kaini/eink-clock/graphics/large_0.png

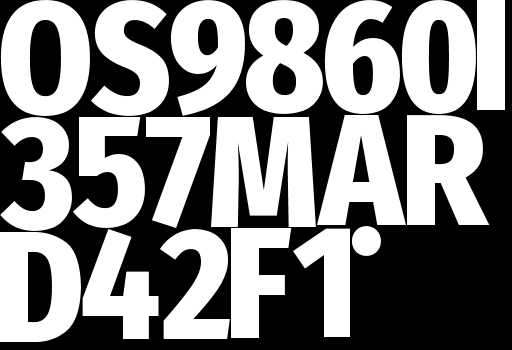
graphics/large_0.png
