kaini/eink-clock/graphics/small_0.png

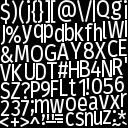
graphics/small_0.png
