kaini/eink-clock/parts.txt

Special Parts

Crystal: 
L1, L4: SDR0703-120KL
L2, L3, L5, L6: CBC3225T100KRV
RV1: TS53YL103MR10
Y1: AB26TRQ-32.768kHz-T
