kaini/eink-clock/kicad/einkclock.kicad_pcb

## KiCad design kicad/einkclock.kicad_pcb (2021-10-04)

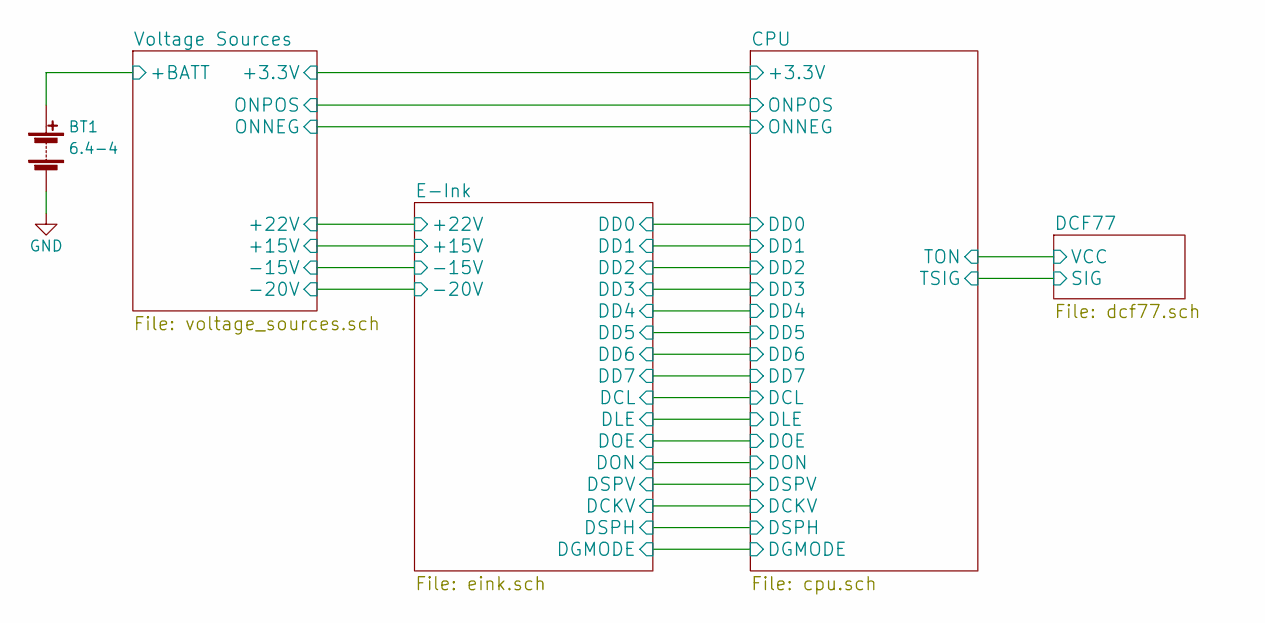
[picture p3: schematic einkclock.sch, E-Ink Clock]

Parts:
BT1: 6.4-4; WireConnection_1.00mmDrill

Connections:
GND: BT1.2 (-); also elsewhere on the board

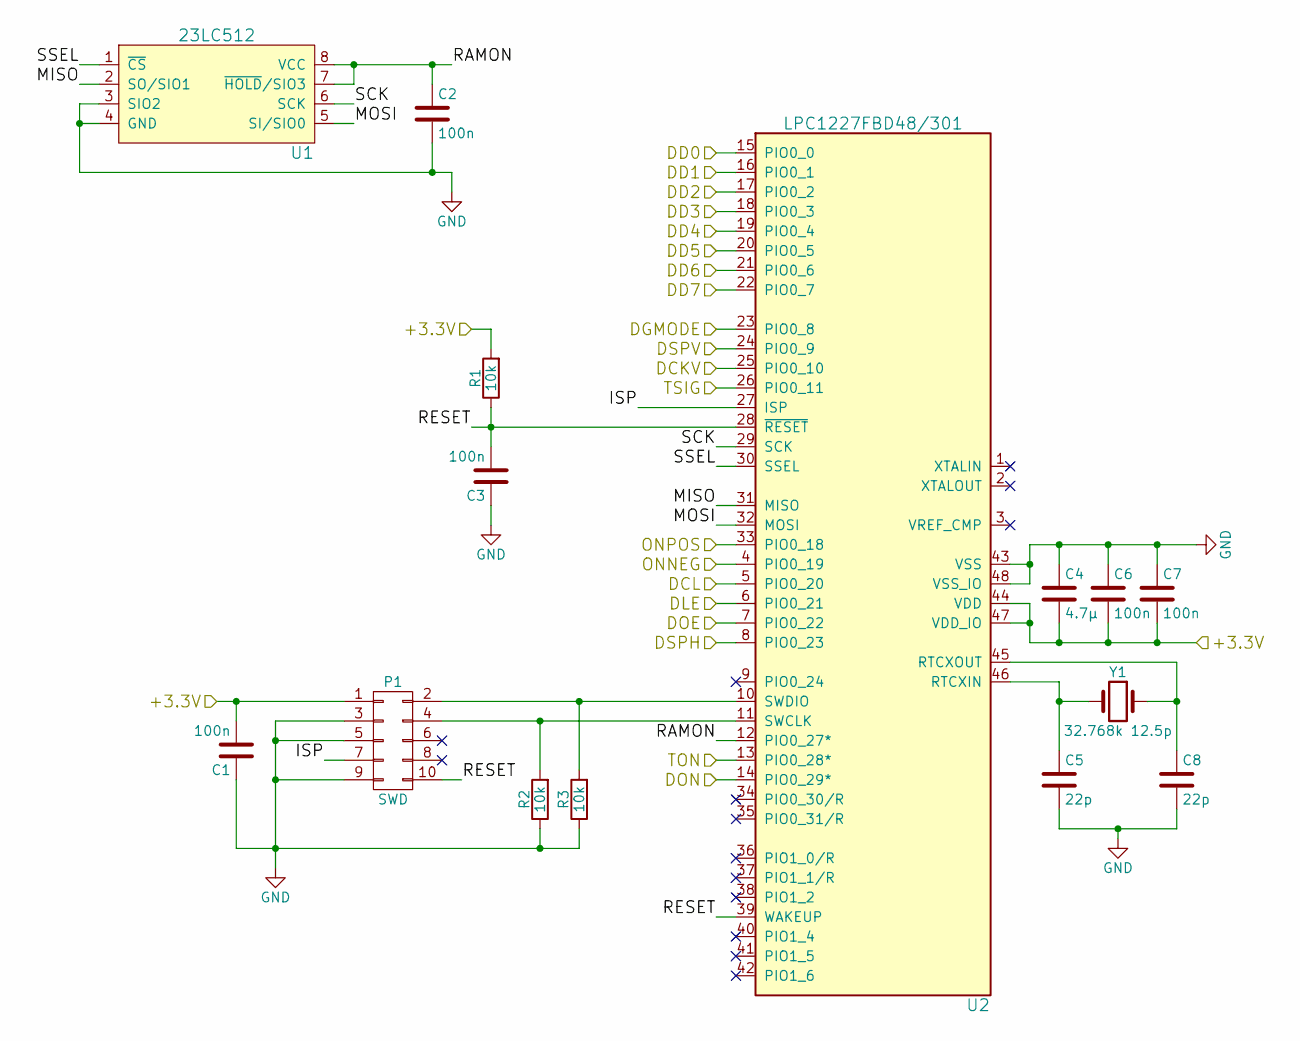
[picture p4: schematic cpu.sch, E-Ink Clock]

Parts:
C1, C2, C3, C6, C7: 100n; R_0805_HandSoldering
C4: 4.7µ; R_0805_HandSoldering
C5, C8: 22p; R_0805_HandSoldering
P1: SWD; IDC_Header_Straight_10pins
R1, R2, R3: 10k; R_0805_HandSoldering
U1: 23LC512; SOIC-8_3.9x4.9mm_Pitch1.27mm
U2: LPC1227FBD48/301; LQFP-48_7x7mm_Pitch0.5mm
Y1: 32.768k 12.5p; Crystal_Lying_1

Connections:
/CPU/+3.3V: C1.2, C4.2, C6.2, C7.2, P1.1, R1.2, U2.44 (VDD), U2.47 (VDD_IO); also elsewhere on the board
/CPU/DCKV: U2.25 (PIO0_10); also elsewhere on the board
/CPU/DCL: U2.5 (PIO0_20); also elsewhere on the board
/CPU/DD0: U2.15 (PIO0_0); also elsewhere on the board
/CPU/DD1: U2.16 (PIO0_1); also elsewhere on the board
/CPU/DD2: U2.17 (PIO0_2); also elsewhere on the board
/CPU/DD3: U2.18 (PIO0_3); also elsewhere on the board
/CPU/DD4: U2.19 (PIO0_4); also elsewhere on the board
/CPU/DD5: U2.20 (PIO0_5); also elsewhere on the board
/CPU/DD6: U2.21 (PIO0_6); also elsewhere on the board
/CPU/DD7: U2.22 (PIO0_7); also elsewhere on the board
/CPU/DGMODE: U2.23 (PIO0_8); also elsewhere on the board
/CPU/DLE: U2.6 (PIO0_21); also elsewhere on the board
/CPU/DOE: U2.7 (PIO0_22); also elsewhere on the board
/CPU/DON: U2.14 (PIO0_29*); also elsewhere on the board
/CPU/DSPH: U2.8 (PIO0_23); also elsewhere on the board
/CPU/DSPV: U2.24 (PIO0_9); also elsewhere on the board
/CPU/ISP: P1.7, U2.27 (ISP)
/CPU/MISO: U1.2 (SO/SIO1), U2.31 (MISO)
/CPU/MOSI: U1.5 (SI/SIO0), U2.32 (MOSI)
/CPU/ONPOS: U2.33 (PIO0_18); also elsewhere on the board
/CPU/RAMON: C2.1, U1.7 (~HOLD~/SIO3), U1.8 (VCC), U2.12 (PIO0_27*)
/CPU/RESET: C3.2, P1.10, R1.1, U2.28 (~RESET), U2.39 (WAKEUP)
/CPU/SCK: U1.6 (SCK), U2.29 (SCK)
/CPU/SSEL: U1.1 (~CS), U2.30 (SSEL)
/CPU/TON: U2.13 (PIO0_28*); also elsewhere on the board
/DCF77/SIG: U2.26 (PIO0_11); also elsewhere on the board
GND: C1.1, C2.2, C3.1, C4.1, C5.2, C6.1, C7.1, C8.2, P1.3, P1.5, P1.9, R2.1, R3.1, U1.3 (SIO2), U1.4 (GND), U2.43 (VSS), U2.48 (VSS_IO); also elsewhere on the board
unnamed: C5.1, U2.46 (RTCXIN), Y1.2
unnamed: C8.1, U2.45 (RTCXOUT), Y1.1
unnamed: P1.2, R3.2, U2.10 (SWDIO)
unnamed: P1.4, R2.2, U2.11 (SWCLK)

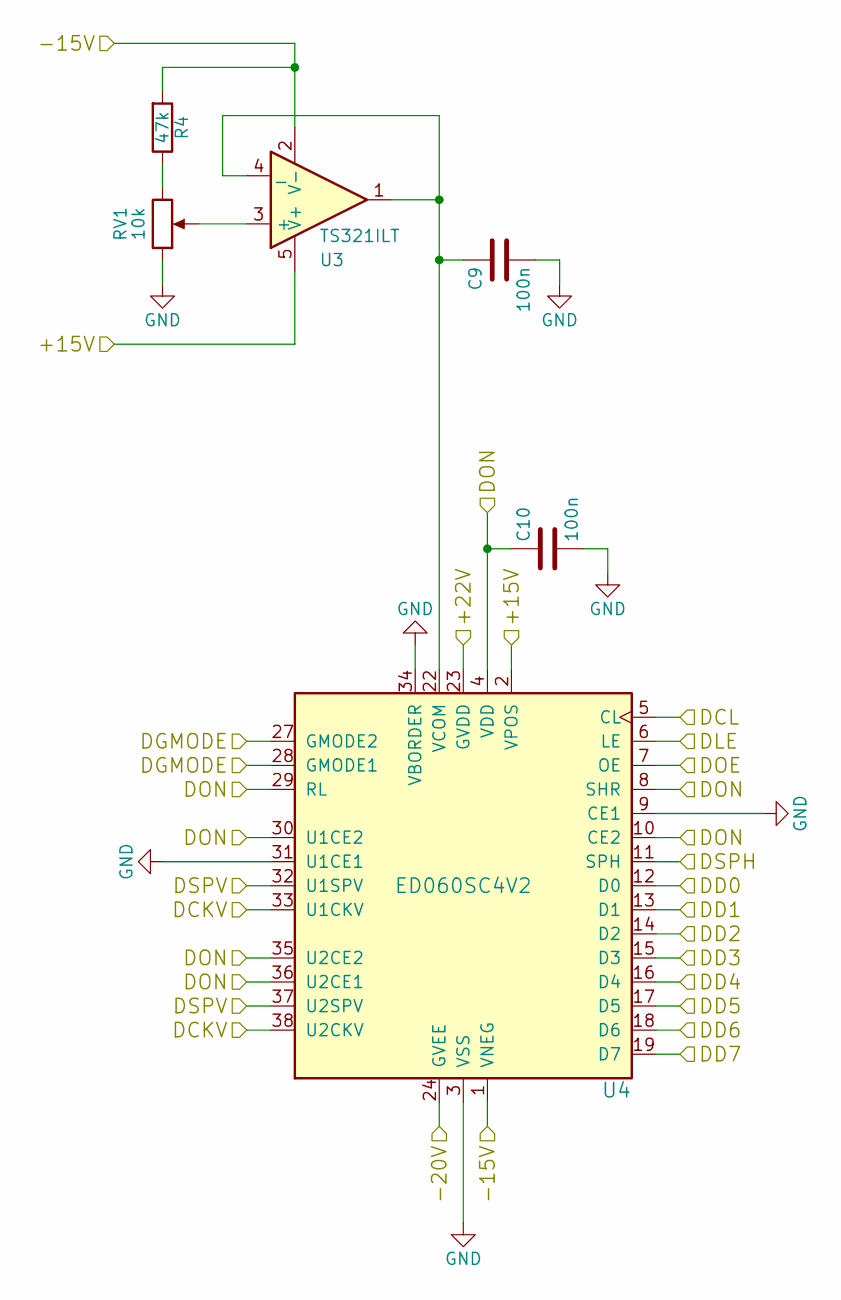
[picture p5: schematic eink.sch, E-Ink Clock]

Parts:
C9, C10: 100n; R_0805_HandSoldering
R4: 47k; R_0805_HandSoldering
RV1: 10k; Potentiometer_Trimmer_Vishay_TS53YL
U3: TS321ILT; SOT-23-5_HandSoldering
U4: ED060SC4V2; Hirose_FH26-39S-0.3SHW

Connections:
/CPU/DCKV: U4.33 (U1CKV), U4.38 (U2CKV); also elsewhere on the board
/CPU/DCL: U4.5 (CL); also elsewhere on the board
/CPU/DD0: U4.12 (D0); also elsewhere on the board
/CPU/DD1: U4.13 (D1); also elsewhere on the board
/CPU/DD2: U4.14 (D2); also elsewhere on the board
/CPU/DD3: U4.15 (D3); also elsewhere on the board
/CPU/DD4: U4.16 (D4); also elsewhere on the board
/CPU/DD5: U4.17 (D5); also elsewhere on the board
/CPU/DD6: U4.18 (D6); also elsewhere on the board
/CPU/DD7: U4.19 (D7); also elsewhere on the board
/CPU/DGMODE: U4.27 (GMODE2), U4.28 (GMODE1); also elsewhere on the board
/CPU/DLE: U4.6 (LE); also elsewhere on the board
/CPU/DOE: U4.7 (OE); also elsewhere on the board
/CPU/DON: C10.1, U4.4 (VDD), U4.8 (SHR), U4.10 (CE2), U4.29 (RL), U4.30 (U1CE2), U4.35 (U2CE2), U4.36 (U2CE1); also elsewhere on the board
/CPU/DSPH: U4.11 (SPH); also elsewhere on the board
/CPU/DSPV: U4.32 (U1SPV), U4.37 (U2SPV); also elsewhere on the board
/E-Ink/+15V: U3.5 (V+), U4.2 (VPOS); also elsewhere on the board
/E-Ink/+22V: U4.23 (GVDD); also elsewhere on the board
/E-Ink/-15V: R4.2, U3.2 (V-), U4.1 (VNEG); also elsewhere on the board
/E-Ink/-20V: U4.24 (GVEE); also elsewhere on the board
GND: C9.2, C10.2, RV1.1, U4.3 (VSS), U4.9 (CE1), U4.31 (U1CE1), U4.34 (VBORDER); also elsewhere on the board
unnamed: C9.1, U3.1, U3.4 (_), U4.22 (VCOM)
unnamed: R4.1, RV1.3
unnamed: RV1.2, U3.3 (+)

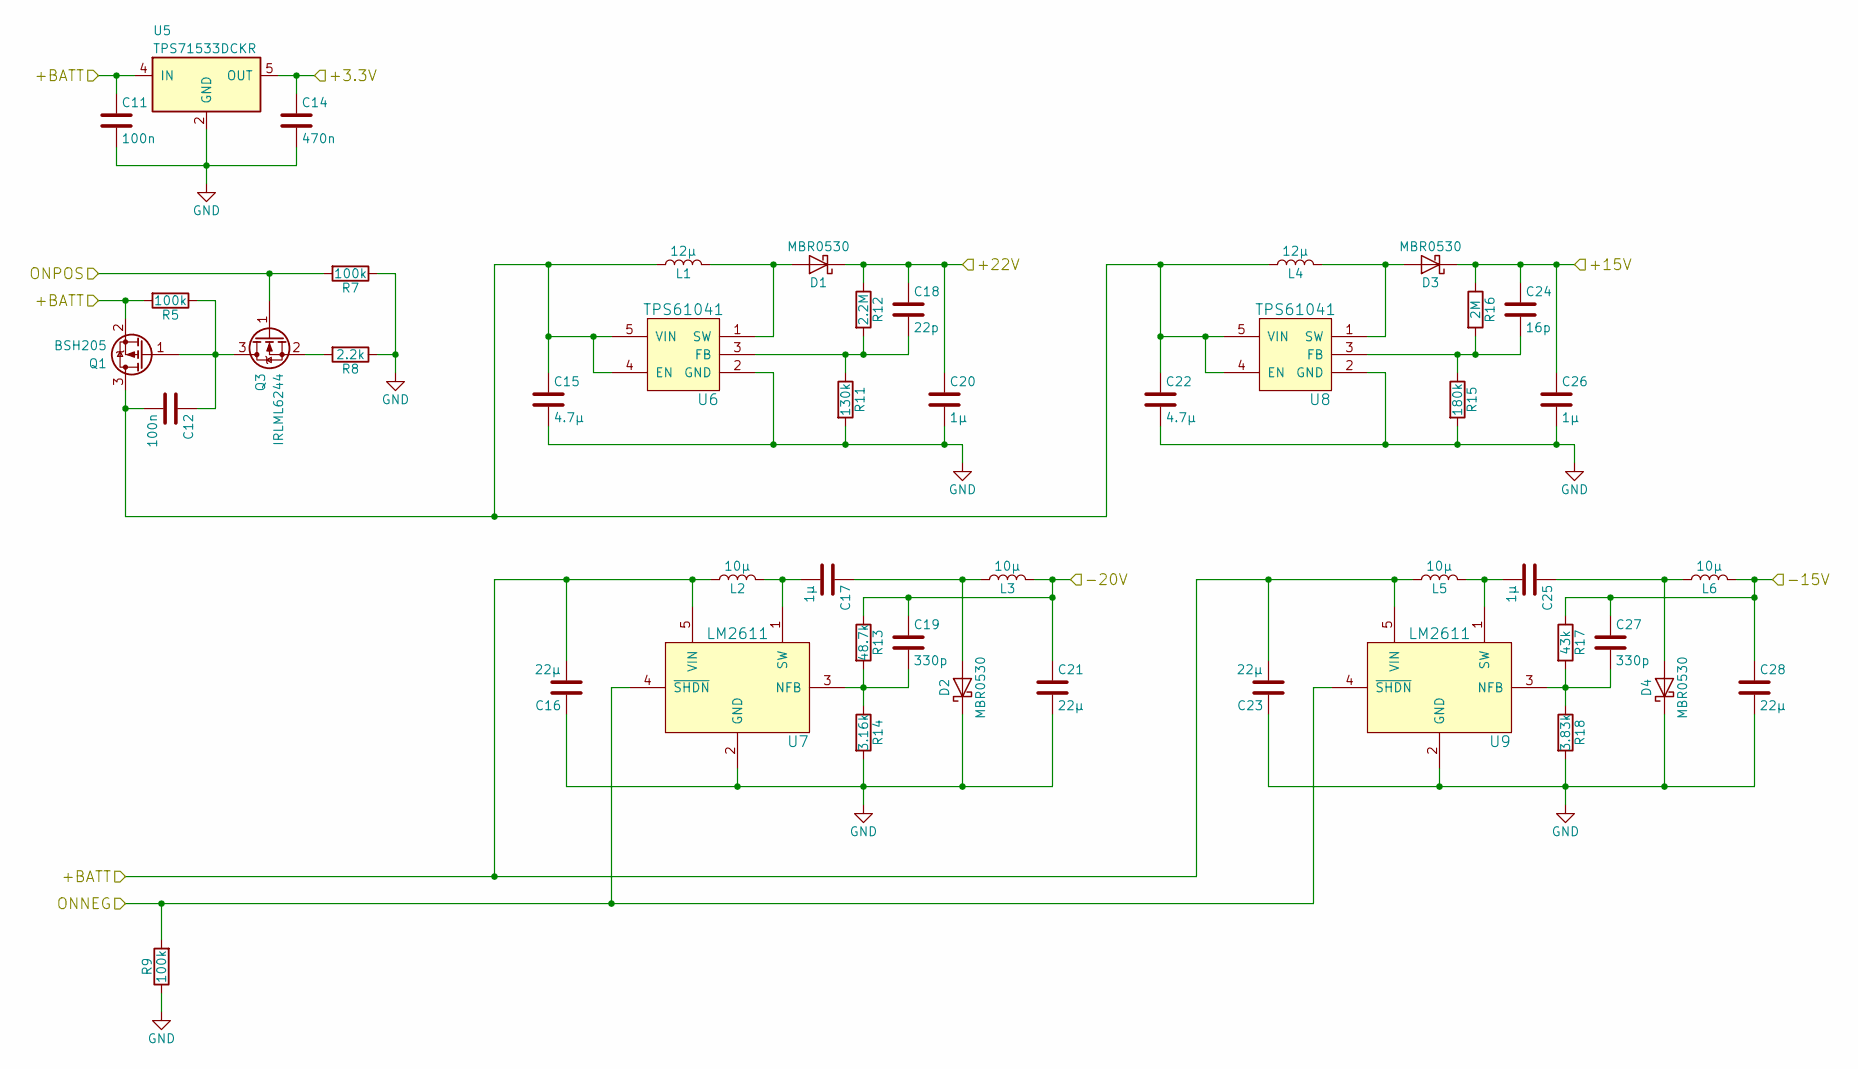
[picture p6: schematic voltage_sources.sch, E-Ink Clock]

Parts:
C11, C12: 100n; R_0805_HandSoldering
C14: 470n; R_0805_HandSoldering
C15, C22: 4.7µ; R_0805_HandSoldering
C16, C21, C23, C28: 22µ; R_0805_HandSoldering
C17, C20, C25, C26: 1µ; R_0805_HandSoldering
C18: 22p; R_0805_HandSoldering
C19, C27: 330p; R_0805_HandSoldering
C24: 16p; R_0805_HandSoldering
D1, D2, D3, D4: MBR0530; D_SOD-123
L1, L4: 12µ; Bourns_Inductor_SDR0703
L2, L3, L5, L6: 10µ; Inductor_TAIYO_YUDEN_3225
Q1: BSH205; SOT-23_Handsoldering
Q3: IRLML6244; SOT-23_Handsoldering
R5, R7, R9: 100k; R_0805_HandSoldering
R8: 2.2k; R_0805_HandSoldering
R11: 130k; R_0805_HandSoldering
R12: 2.2M; R_0805_HandSoldering
R13: 48.7k; R_0805_HandSoldering
R14: 3.16k; R_0805_HandSoldering
R15: 180k; R_0805_HandSoldering
R16: 2M; R_0805_HandSoldering
R17: 43k; R_0805_HandSoldering
R18: 3.83k; R_0805_HandSoldering
U5: TPS71533DCKR; SOT-353_SC-70-5_Handsoldering
U6, U8: TPS61041; SOT-23-5_HandSoldering
U7, U9: LM2611; SOT-23-5_HandSoldering

Connections:
/CPU/+3.3V: C14.1, U5.5 (OUT); also elsewhere on the board
/CPU/ONPOS: Q3.1 (G), R7.2; also elsewhere on the board
/E-Ink/+15V: C24.1, C26.1, D3.1 (K), R16.1; also elsewhere on the board
/E-Ink/+22V: C18.1, C20.1, D1.1 (K), R12.1; also elsewhere on the board
/E-Ink/-15V: C27.1, C28.1, L6.2, R17.1; also elsewhere on the board
/E-Ink/-20V: C19.1, C21.1, L3.2, R13.1; also elsewhere on the board
GND: C11.2, C14.2, C15.2, C16.1, C20.2, C21.2, C22.2, C23.1, C26.2, C28.2, D2.1 (K), D4.1 (K), R7.1, R8.1, R9.1, R11.2, R14.2, R15.2, R18.2, U5.2 (GND), U6.2 (GND), U7.2 (GND), U8.2 (GND), U9.2 (GND); also elsewhere on the board
unnamed: C12.1, Q1.1 (G), Q3.3 (D), R5.1
unnamed: C12.2, C15.1, C22.1, L1.1, L4.1, Q1.3 (D), U6.4 (EN), U6.5 (VIN), U8.4 (EN), U8.5 (VIN)
unnamed: C17.1, D2.2 (A), L3.1
unnamed: C17.2, L2.2, U7.1 (SW)
unnamed: C18.2, R11.1, R12.2, U6.3 (FB)
unnamed: C19.2, R13.2, R14.1, U7.3 (NFB)
unnamed: C24.2, R15.1, R16.2, U8.3 (FB)
unnamed: C25.1, D4.2 (A), L6.1
unnamed: C25.2, L5.2, U9.1 (SW)
unnamed: C27.2, R17.2, R18.1, U9.3 (NFB)
unnamed: D1.2 (A), L1.2, U6.1 (SW)
unnamed: D3.2 (A), L4.2, U8.1 (SW)
unnamed: Q3.2 (S), R8.2

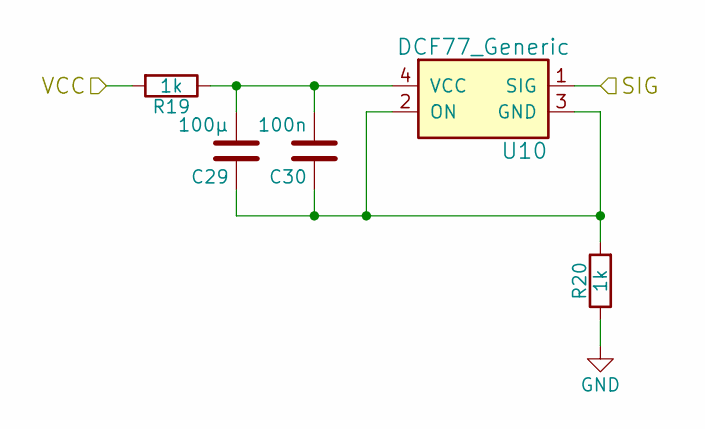
[picture p7: schematic dcf77.sch, E-Ink Clock]

Parts:
C29: 100µ; R_1206_HandSoldering
C30: 100n; R_0805_HandSoldering
R19, R20: 1k; R_0805_HandSoldering
U10: DCF77_Generic; Reichelt_DCF77_Module

Connections:
/CPU/TON: R19.2; also elsewhere on the board
/DCF77/SIG: U10.1 (SIG); also elsewhere on the board
GND: R20.1; also elsewhere on the board
unnamed: C29.1, C30.1, R20.2, U10.2 (ON), U10.3 (GND)
unnamed: C29.2, C30.2, R19.1, U10.4 (VCC)

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
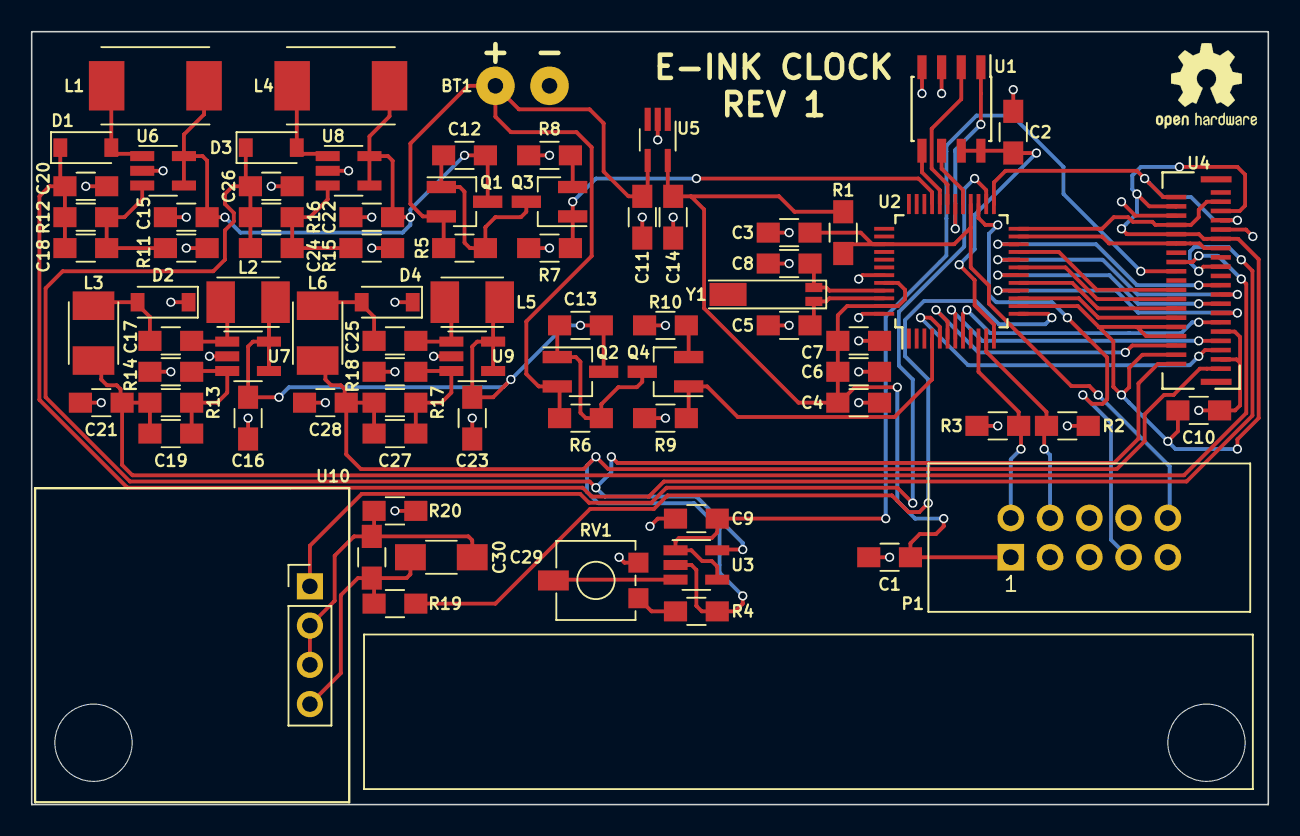
[picture p8: board einkclock.kicad_pcb from above]

Board: 2 copper layers, 80.0 x 50.0 mm, 78 parts (0 on the bottom side), 59 nets.

Other parts of the board:
C13: 100n; R_0805_HandSoldering
Q2: BSH205; SOT-23_Handsoldering
Q4: IRLML6244; SOT-23_Handsoldering
R6: 100k; R_0805_HandSoldering
R10: 2.2k; R_0805_HandSoldering

Their connections:
GND: R10.1; also elsewhere on the board
unnamed: C13.1, Q2.1, Q4.3, R6.1
unnamed: Q4.2, R10.2
