kaini/eink-clock/timekeeper/src/rawhw/counter.rs

macro_rules! counter_register {
    ($name:ident, $address:expr) => (
        pub mod $name {
            register_block! {
                ir   ($address + 0x00) => {
                    0, mr0int, bool;
                    1, mr1int, bool;
                    2, mr2int, bool;
                    3, mr3int, bool;
                    4, cr0int, bool;
                    5, cr1int, bool;
                    6, cr2int, bool;
                    7, cr3int, bool;
                }
                tcr  ($address + 0x04), andmask 0b11 => {
                    0, cen, bool;
                    1, crst, bool;
                }
                tc   ($address + 0x08) => {
                    0,15, tc, u16;
                }
                pr   ($address + 0x0C) => {
                    0,15, pcval, u16;
                }
                pc   ($address + 0x10) => {
                    0,15, pc, u16;
                }
                mcr  ($address + 0x14), andmask 0b111111111111 => {
                    0, mr0i, bool;
                    1, mr0r, bool;
                    2, mr0s, bool;
                    3, mr1i, bool;
                    4, mr1r, bool;
                    5, mr1s, bool;
                    6, mr2i, bool;
                    7, mr2r, bool;
                    8, mr2s, bool;
                    9, mr3i, bool;
                    10, mr3r, bool;
                    11, mr3s, bool;
                }
                mr0  ($address + 0x18), andmask 0xFFFF => { full; }
                mr1  ($address + 0x1C), andmask 0xFFFF => { full; }
                mr2  ($address + 0x20), andmask 0xFFFF => { full; }
                mr3  ($address + 0x24), andmask 0xFFFF => { full; }
                ccr  ($address + 0x28), andmask 0b111111111111 => {
                    0, cap0re, bool;
                    1, cap0fe, bool;
                    2, cap0i, bool;
                    3, cap1re, bool;
                    4, cap1fe, bool;
                    5, cap1i, bool;
                    6, cap2re, bool;
                    7, cap2fe, bool;
                    8, cap2i, bool;
                    9, cap3re, bool;
                    10, cap3fe, bool;
                    11, cap3i, bool;
                }
                cr0  ($address + 0x2C), andmask 0xFFFF => { full; }
                cr1  ($address + 0x30), andmask 0xFFFF => { full; }
                cr2  ($address + 0x34), andmask 0xFFFF => { full; }
                cr3  ($address + 0x38), andmask 0xFFFF => { full; }
                emr  ($address + 0x3C) => {
                    // TODO
                }
                ctcr ($address + 0x70) => {
                    // TODO
                }
                pwmc ($address + 0x74) => {
                    // TODO
                }
            }
        }
    )
}

counter_register!(ct16b0, 0x40010000);
counter_register!(ct16b1, 0x40014000);
