kaini/eink-clock/(commit log)

2017-02-17 Add fixes to KiCad schematc
    [einkclock.sch]
2017-02-19 Start PCB routing
    [einkclock.kicad_pcb, einkclock.sch]
2017-02-19 Remove redundand KiCad files
2017-02-20 Cleanup KiCad files and route board
2017-02-20 Add ground layer
    [einkclock.kicad_pcb]
2017-03-07 Remove direct C dependency
    [lpc1227.cfg]
2017-03-07 Remove C startup code
    [lpc1227.cfg]
2017-03-09 Fix linker script
    [lpc1227.cfg]
2017-03-19 Fix and change build process
    [cpu.rs, timekeeper.rs]
2017-03-24 Add deep power down stuff
2017-03-26 Fixup schematic
    [einkclock.sch]
2017-03-26 Schematic fixes
    [einkclock.sch]
2017-03-29 Rework schematic
    [cpu.sch, dcf77.sch, eink.sch, einkclock.sch, voltage_sources.sch]
2017-03-30 Finish schematic
    [cpu.sch, dcf77.sch, eink.sch, einkclock.sch, voltage_sources.sch]
2017-03-30 Set most footprints
    [cpu.sch, dcf77.sch, eink.sch, einkclock.sch, voltage_sources.sch]
2017-03-30 Finish footprints
    [cpu.sch, eink.sch, einkclock.kicad_pcb, voltage_sources.sch]
2017-04-01 First routing
    [cpu.sch, dcf77.sch, eink.sch, einkclock.kicad_pcb, voltage_sources.sch]
2017-04-03 Add BOM
    [cpu.sch, dcf77.sch, eink.sch, voltage_sources.sch]
2017-04-04 Finish BOM and fix PCB according to the parts
    [cpu.sch, einkclock.kicad_pcb, einkclock.sch]
2017-04-04 Refine BOM
    [voltage_sources.sch]
2017-04-04 Make BOM friendlier for some BOM parsers
2017-05-04 Fix LM2611 switch
    [voltage_sources.sch]
2017-05-04 Rasterize instead of trace
2017-05-10 Update date
    [cpu.sch, dcf77.sch, eink.sch, einkclock.sch, voltage_sources.sch]
